Ravanger/canvas-glow/(commit log)

2026-10-09 docs: diode identification, torch-test result, cert workaround
2026-10-09 docs: make the fuse optional rather than unneeded
2026-10-09 docs(guide): add solderless breadboard bench steps
2026-10-09 docs(guide): fix debug example, FAULT causes and base resistor floor
2026-10-09 docs: add breadboard and final wiring drawings
2026-10-09 docs(breadboard): allow a plain LED as the bench load
2026-10-09 fix(firmware): correct base current estimate in comment
2026-10-11 feat: drop hover sensor and mode switch, knob-only dimming
    The capacitive hover sensor was unreliable on the bench. The light is now
    a plain dimmable halo: the knob always sets brightness, the bottom of the
    turn is off. Also removes the mode switch and the night auto-off timer.
    One 5 V 2 A adapter still powers both the ESP32 and the strip.
2026-10-11 feat: replace ESP32 with discrete transistor PWM dimmer
    Two-transistor astable (2N3904) timed by the B500K pot sets duty;
    2N7000 + BC327 buffer drives the four BC337 strip channels. Firmware,
    platformio.ini and the PlatformIO extension recommendation removed.
    Guides, README and drawings rewritten for the discrete circuit.
2026-10-15 feat: 2N3904 buffer instead of 2N7000, Rb 100k
    - Q3 is a 2N3904 driven from Q2 C through 47k
    - Rb 100k: max duty ~83%, total ~1.65 A at full
    - Step 1 test LED on 470 ohm so Q3 saturates
    - Replug test and latch-up troubleshooting row
2026-10-15 docs: breadboard test uses an LED only, no COB strip
2026-10-21 feat: IC version of the dimmer (NE555), alongside the discrete version
    Adds a second dimmer built around an NE555 instead of the
    two-transistor oscillator, with the same four BC337 output
    channels, same strip, same power. The discrete version is
    untouched; the README now presents both.
    - docs/GUIDE-IC.md: full IC build guide
    - docs/BREADBOARD-IC.md: bench test, no soldering
    - docs/img/wiring-ic.svg, docs/img/breadboard-ic.svg: IC drawings
2026-10-21 fix: correct 555 frequency for diode drops, note BC337 maker ratings
    The 1.1 kHz figure was the ideal no-diode-drop number. With the
    1N4148 drops at the microamp timing currents, the period stretches
    to ~1.1 ms (~0.9 kHz); the duty is barely affected because charge
    and discharge stretch together. Same correction to the timing-cap
    range (1 nF ~2 kHz, 4.7 nF ~400 Hz) and both SVG subtitles.
    Also: BC337 is 800 mA onsemi but 500 mA DC (1 A peak) Philips/NXP.
    Either is fine here (long sides peak 0.54 A, average 0.45 A at the
    83% cap) — noted so an NXP datasheet does not cause confusion.
    Small clarifications: pin-3 check reads DC (~2.7 V at full, peak
    ~3.3 V); breadboard step-2 LED current is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
2026-10-21 fix: 555 PWM topology (wiper to pin 7, 10k pull-up)
    The first version tied pot end 1 to +5V, which put a divider on the discharge path and killed oscillation for most of the knob travel (output stuck low below ~80%). The standard diode-steered form has the wiper on pin 7, a 10k pull-up, and the pot ends on D1 and (via 100k) D2, so neither path has a divider. Duty is now ~3.5-83%, and the bottom of the turn is a faint glow, not off.
    Also: 10-47uF at pins 8/1 for rail stability, ULN2803/2003 ruled out in the transistor table, A500K section dropped (B500K on hand), RESET-switch option for a true off, base-resistor fallback recheck.
2026-10-21 fix: IC drawing and doc issues from review
    - Wiper wire rerouted to y=328 so it clears the pin-5 cap plates
    (was running through them, looked like a short); pin-7 node
    moved to x=415 so the vertical clears the 6 THR / 7 DISCH labels
    - Pot end labels A/B moved above the pot ends (A was invisible
    inside the D1 triangle, B sat on the end-B wire)
    - 10-47 uF drawn as a polarized cap (curved negative plate, +
    mark on the positive lead) and + lead noted in the parts row
    and breadboard table
    - Guide changelog language removed (unmerged PR, nobody built
    the old version); breadboard symptom row now reads as plain
    miswiring
    - Pot ends defined: A = counter-clockwise, B = clockwise, so
    cl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
2026-10-21 fix: IC drawing nits from second review round
    - Breadboard 10-47 uF ground wire jogs left at y=200 and runs
    down at x=215, clear of the pin 1/2/4 stubs it used to cross
    - Electrolytic leads start at the curved plate apex (no 3 px
    gap): 10-47 uF in both SVGs, bulk cap in both SVGs
    - Wiring decoupling 100 nF label moved to y=208, clear of the
    ground symbol it nearly touched
    - Guide 'Works backwards' row shortened to 'swap the two end
    legs' to match the other wordings
2026-10-21 fix: IC drawing label collisions, caps to 16 V
    - Left pin labels moved inside the chip body in both SVGs:
    this clears the RESET, pin-2 and jog verticals that struck
    through 1 GND, 2 TRIG, 3 OUT and 4 RESET (including the
    jog vertical added last round)
    - Wiring: 4 POWER CHANNELS header moved above the first
    100 ohm label; bulk cap labels shifted left, clear of the
    red RESET wire
    - Wiring: pin-5 100 nF label moved up, clear of 5 CTRL
    - Breadboard: bulk label moved above the rail, decoupling
    100 nF moved clear of the cap wires, subtitle lines end
    left of the jack ground wire, pin 3 note moved right of
    the 2.2 nF ground wire
    - Electrolytics bumped to >= 16 V rating (was 10 V): ch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
2026-10-21 fix: IC drawing label collisions, round 5
    - NE555 title moved high in the chip body, clear of 3 OUT
    (y=340 would have landed on 4 RESET, so it went up
    instead)
    - Pin-5 cap plates shifted right to clear 5 CTRL, its 100 nF
    label now sits between the pin-6 and wiper wires
    - Breadboard pin-3 note moved right of the pin-5 ground
    wire and below the dashed box
    - Breadboard decoupling 100 nF moved to the left side of
    its cap, clear of the RESET wire
2026-10-21 fix: IC drawing detached label and pin-5 cap details
    - Breadboard decoupling label shortened to 100n and tucked
    in the gap beside its cap (was detached beside the jack)
    - Pin-5 100 nF label moved below the stub in both drawings
    (was sitting between wires where it could read as labelling
    the wiper wire)
    - Pin-5 ground wire now starts at the second plate's lower
    tip instead of overlapping the plate
2026-10-23 Add SPICE verification sims for guide circuits
    Netlists + models + helpers used to verify the numeric claims in
    docs/GUIDE.md and docs/GUIDE-IC.md (discrete astable and NE555 PWM):
    steady-state frequency, duty cycle, rail levels, and total current at
    three knob positions. README covers running ngspice without root,
    gotchas learned, and the results tables cited in the findings report.
2026-10-23 F1: discrete top duty is ~86%, not 83/81%
    Ideal 0.693RC formula gives 82.7%; both sims measure 85.4-85.9%.
    The gap: Vbe/Vce thresholds lengthen Q2's off-time, and Q3's 47k
    caps Q2C's swing at ~4.25 V, shortening Q1's on-time. §2 power
    framing corrected to the sim-measured totals (1.52-1.57 A, i.e.
    ~1.65 A or under — the old figure was conservative).
2026-10-23 F2: IC minimum duty is 1.6-2%, not 3.5%
    Arithmetic error: the line's own formula gives 10k/610k = 1.64%;
    sims measure 1.57-2.0%. Fixed in all copies: GUIDE-IC §3, §4, §8
    (bottom check 0.1 V -> 0.06 V; the 2.7 V top check is unchanged —
    datasheet-typical pin-3 high under load) and §9, plus the
    BREADBOARD-IC Step 2 pass line (N3).
2026-10-23 F3: make the discrete §9 rail check readable with a DC meter
    The specified tool reads the average (~4.0 V at full), not the
    scope peak (4.86-4.93 V in sims). '4.6 V or more' was unreachable;
    now states both readings.
2026-10-23 F4: add the second 10 kΩ needed by the RESET switch mod
    The §9 'real off switch' row replaces the pin 4 -> +5V tie with a
    10 kΩ pull-up, but the parts table listed only one 10 kΩ (pin 7).
2026-10-23 F5: qualify the breadboard LED current by color
    (5-1.9)/220 ≈ 14 mA for red; (5-3.2)/220 ≈ 8 mA for white/blue —
    now matches the IC breadboard doc's wording.
2026-10-23 F6: widen the discrete bottom check band to ~0-0.1 V
    A build showing the documented faint glow reads ~0.074 V DC on the
    drive rail (sim), which failed the old 0-0.05 V pass band; both
    documented outcomes (stall at 0 V, faint glow) now pass.
2026-10-23 T1: state per-version PWM frequency in the versions table
    Discrete ~1 kHz, IC ~0.9 kHz (sims: 893-907 Hz own / ~980 Hz
    external for the IC; the intro's '~1 kHz' stays as a round figure).
2026-10-23 F7: align electrolytic ratings to >=16 V
    The IC guide already specifies >=16 V on the same 5 V supply;
    both are safe, now one value across both guides.
2026-10-23 N6: reword the diode-drop sentence in §4
    'the duty barely moves' could be misread as the duty being constant
    across the knob (it runs 1.6-83%); it means the diode drops barely
    change the duty versus the ideal calculation.
2026-10-23 N1: add the breadboard-test parts to both parts tables
    The breadboard docs have no parts list of their own, and the LED
    current-limit resistors (470/220 Ω discrete, 220 Ω IC) plus the test
    LED appeared in neither guide's table — a builder following the
    table alone could not run the bench tests.
2026-10-23 N2: add the BC337 maker note to the discrete guide
    Mirrors the IC guide's note, with the discrete averages: ~0.46 A at
    the 86% cap (0.54 x 0.86) — under NXP's 500 mA DC but with less
    margin than the IC version's 0.45 A.
2026-10-23 N5: specify a slow-blow (T) fuse, not a fast one
    The 470-1000 uF bulk caps draw inrush on plug-in; a fast fuse risks
    nuisance-tripping where a slow-blow (or the PTC, listed first)
    tolerates it.
2026-10-23 Fix F1 mechanism wording: Q1's off-time, not on-time
    Q1 on-time IS Q2 off-time (both are the drive-high phase), so the
    old sentence claimed that phase both lengthens and shortens. The
    capped Q2C swing (~4.25 V) makes the coupling step onto Q1B smaller,
    so Q1's base recovers faster — that shortens Q1's OFF-time, the
    drive-low phase (sim: post-step -3.53 V, recovery factor 0.685 vs
    ideal 0.693).
2026-10-23 Fix 555a.lib header: VOH is pessimistic, not optimistic
    Measured sag is ~2.6 V no-load / ~1.8 V under full load vs 3.3-3.5 V
    on real parts — below reality, so pessimistic. The old 'no beta
    roll-off' justification was also wrong; the README attributes the
    sag to latch-node loading under the follower's base drive.
2026-10-23 List the bulk cap in both breadboard Step 1 tables
    Both drawings show the 470-1000 uF power-entry cap at the jack, but
    neither Step 1 wire table listed it. Electrically optional at bench
    currents (the 100 uF / 10-47 uF already decouple), but the table must
    match the drawing.
2026-10-23 Fix the sanity.cir row: measured ~255 Hz, band re-derived from tolerances
    The old row said '262.5 Hz / 3.92 ms period' — not reciprocals (262.5
    Hz = 3.81 ms; 3.92 ms = 255 Hz), and 262.5 sat just above the row's own
    expected band. Fresh run: periods 3.919-3.921 ms -> ~255 Hz, in-band.
    The band is re-derived analytically (a single log run gives a point, not
    a band): ideal 1.44/((RA+2RB)C) = 261.8 Hz; worst-case low with R +1%,
    C +5% = 246.9 Hz -> ~247-262 Hz, matching the original derivation
    within rounding.
2026-10-23 State that the discrete version has no off switch
    The Configuration list mentions the IC version's optional latching
    off switch but says nothing for the discrete version. One line
    completes it: unplug the adapter to switch off.
2026-10-23 Add a power-budget rounding note to both guides' section 2
    The tables round the exact figures (0.544 A long sides, 0.384 A
    short sides, 1.856 A total at 1.6 A per metre) to 0.54 / 0.38 /
    1.86 A. One note line after each table states the exact values;
    no table or paragraph number changed.
2026-10-23 Add a never-lights power check to both breadboard Step 1 Pass paragraphs
    A fully dark LED is a power problem (adapter polarity, 5 V rail
    actually ~5 V), distinct from the existing 'dark for most of the
    travel' miswire sentence. One sentence appended to each doc's
    Step 1 Pass paragraph.
2026-10-23 Fix the invalid section 8 DC checks on PWM-switched nodes
    The 'Transistor drop' (under 0.4 V good, over 0.6 V -> lower that
    base resistor) and 'Strip voltage' (4.5 V or more) rows judged
    PWM-switched nodes with a DC multimeter, which reads the
    duty-dependent average, not the on-state value. At full knob a
    healthy circuit averages ~0.8 V (discrete) / ~1.0 V (IC) across the
    BC337 and ~4.2 V / ~4.0 V across the strip, so it failed both
    checks; the Vce check passed only for a stuck-on fault. Reaching
    under 0.4 V needs over ~95% duty and 4.5 V over ~93%, beyond the
    knob caps (86% / 81-83%). Fresh runs of the committed sims
    (disc_endB.cir, ic_pwm_endB.cir) confirm: on-state collector
    plateau 0.08-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
2026-10-23 Warn against CMOS 555 substitutes in the IC guide
    The parts table specifies an NE555 but nothing warned against a
    CMOS substitute. The four base resistors (100/150 ohm from ~3.3 V
    pin 3 to ~0.7 V base) demand ~87 mA on-state, while the TLC555
    sources only ~10 mA typical (TI datasheet; absolute max 15 mA).
    One note after the parts table: use a bipolar NE555, and do not
    substitute without revalidating output drive.
2026-10-23 Label theory vs simulation figures in both power budgets
2026-10-23 State the one-channel pin-3 figure as higher than 2.7 V, not a measurement
2026-10-23 Tell builders to use their strip's pitch and rated power, with the current formula
2026-10-23 Say the 36 x 25.8 cm opening is the tested painting's; measure your own
2026-10-23 Label the fuse current as hold/rating and warn about stuck-full-on
2026-10-23 Fix BC337 maker-check wording: onsemi's 800 mA is a continuous rating, not a peak rating
2026-10-23 Harmonize the pin-3 load figure to ~87 mA in the 555 notes
2026-10-23 Resolve §2 conflict with main: keep strip-assumptions paragraph and labelled power budget
2026-10-24 GUIDE §4: call the end-B duty simulated, not measured
    The end-B figure came from simulation, not bench measurement. Quotes the 78–86% band across the sim runs in sim/README.md.
    Numbers: 78–86% is the band quoted in sim/README.md (line 121).
2026-10-24 GUIDE-IC §2: give the simulated total as a share of the adapter
    The 83% figure was the theoretical share; the simulated total is 1.52–1.57 A, which is the share shown here. Same wording as GUIDE.md §2.
    Numbers: 1.52/2 = 76%, 1.57/2 = 78.5%, quoted as 76–78%; the old 83% was the theory figure and is removed from this sentence.
2026-10-24 Power entry: PTC hold current derates when warm
    The old sentence said the PTC would not trip at full-on current, which does not hold inside a closed frame. Hold current is rated at room temperature, so the sentence now says to prefer 2.5 A and check the derating curve at in-frame temperature.
    Numbers: the new 2.5 A is a rating recommendation, not a computed value. The 2 A count rises by one from the new sentence. Full-on figure 1.86 A + ~0.1 A = ~1.96 A is unchanged from the existing §2 arithmetic.
2026-10-24 Checks: realistic BC337 saturation plateau
    Real BC337 parts often saturate above the sim figure of ~0.1 V, so the pass band is widened to a few tenths of a volt rather than tied to the datasheet number.
2026-10-24 GUIDE-IC: pin 3 pass values allow a datasheet-minimum 555
    The pin 3 pass values assumed a 3.3 V typical high level. A chip at the datasheet minimum sits lower, so the duty and troubleshooting checks now name that minimum and its reading.
    Numbers: NE555 VOH min 2.75 V at IOH = 100 mA, VCC = 5 V (TI datasheet). 0.82 × 2.75 V = 2.26 V, shown as ~2.3 V DC on a weak chip; 2.75 V peak at the minimum.
2026-10-24 GUIDE-IC §8: measure pin 8 with the current meter out
    A meter left in series with the supply drops voltage at full load and would read low at pin 8. The current meter must be out of the circuit for the VCC check.
2026-10-24 GUIDE: BC337 in the oscillator is marginal on VEBO
    The oscillator's BC337 substitute sees a reverse base swing close to its emitter-base breakdown rating. The substitution notes now say so, instead of listing it as equivalent.
    Numbers: BC337 VEBO = 5 V (datasheet). Reverse base swing −4.17 V, from the diag_discrete_q2c sim (sim/README.md: step onto q1b −4.17 V), quoted as ~4.2 V.
2026-10-24 GUIDE §5: diode test for the PNP BC327
    The diode-test lead swap for the PNP was missing; a reader using the NPN pattern on a BC327 would get the wrong base.
2026-10-24 Circuit: identify the pot legs
    End A and end B were defined by rotation only, with no way to tell the legs apart on the part. Adds the usual leg order seen from the front.
2026-10-24 Power entry: local decoupling returns, wire not tracks
    The decoupling capacitors need their own return to the star point, and the +5 V and GND feeds carry up to about 2 A, which perfboard tracks cannot.
    Numbers: no new figures. The added tokens restate existing component values (100 µF + 100 nF in GUIDE; 100 nF + 10–47 µF in GUIDE-IC) and the ~2 A feed current from §2 (1.86 A + ~0.1 A).
2026-10-24 Parts: jack rating, low-ESR bulk cap, timing cap type, IC extras
    Parts table gaps: the jack needs a rating that covers the fault current, the bulk cap should be low-ESR, the timing capacitor's dielectric matters for stability, and the IC build can use a socket and a real off switch.
    Numbers: 3 A = jack rating above the ~1.96 A full-on fault current (1.86 A + ~0.1 A base drive, §2).
2026-10-24 Power budget: duty figures are nominal
    The duty percentages are nominal. Pot tolerance and part spread shift the top of the knob, so the note points readers at the total current check in section 8.
2026-10-24 Drawings: move labels off wires
    Three labels sat on wires or rails: 'step 1 only' crossed the LED wire, the +5 V and GND rails ran under their labels, and the pin 3 caption ran into the wire at x=640. Only text positions and the rail end x changed; no values or connections.
2026-10-24 Drawings: clear the two moved labels
    breadboard.svg: 'step 1 only' overlapped the 1k label and the dashed
    box edge; centred in the box above it.
    breadboard-ic.svg: the pin 3 label crossed the CTRL-cap ground wire at
    x=480; start it at x=490, clear of the step-1 wire at x=640.
2026-10-24 check.py: summary also counts problems, not just check lines
    A check line that FAILs can carry WARN problems too; the old summary
    showed 0 WARN in that case.
2026-10-24 Drawings: draw the ground symbol in the wiring legends instead of the U+23DA glyph
    Many fonts lack U+23DA; the legend now reuses the existing #gnd symbol.
2026-10-24 Drawings: move the C2 and RC1 labels off their symbols in wiring.svg
2026-10-24 Parts: carry the 2.5 A PTC preference from section 4 into the parts table
    No new figure: the 2.5 A preference is copied from section 4's fuse note,
    so a builder shopping from the table alone does not buy a 2 A PTC.
2026-10-24 Parts: name example low-ESR series for the bulk capacitor
2026-10-24 sim: recheck supply current and discrete start-up with vendor models
    recheck.py runs ngspice and time-averages the adapter current from wrdata
    output. vendor.lib holds Philips 2N3904 / BC327-25 / BC337-25 / BC337-16
    models from the KiCad SPICE library. Results and limits are in sim/README.md;
    the older strip-plus-base figures are marked superseded.
2026-10-24 Power budget: re-simulated top-of-knob current, both guides
    sim/recheck.py with vendor BJT models, adapter current time-averaged:
    - discrete, 85.5 % duty: 1.588 A at 5.00 V (1.588/2 = 79 %), 1.669 A at
    5.25 V. BC337 Vce(on) 0.236 V -> strip at 4.764 V,
    1.856 x 4.764/5 = 1.77 A on, x 0.855 = 1.51 A; 1.588 - 1.51 = 0.08 A
    base drive + oscillator.
    - IC, 81-83 % duty: 1.445-1.481 A at 5.00 V (72-74 %), 1.518-1.555 A at
    5.25 V. Vce(on) 0.232 V -> 4.77 V, 1.77 A on.
    Replaces 1.52-1.57 A, ~4.85 V and ~1.80 A, which came from generic models
    with no collector resistance (sim/README.md, Recheck section).
2026-10-24 Checks: strip on-voltage from the re-simulated saturation drop
    sim/recheck.py: BC337 Vce(on) 0.23-0.25 V at 0.38-0.54 A in every case,
    so the switched strip sees ~4.75 V, not ~4.9 V. Datasheet bound: onsemi
    BC337 VCE(sat) max 0.7 V at IC = 500 mA, IB = 50 mA.
2026-10-24 Checks: drive-rail DC level at full from the re-simulation
    sim/recheck.py, discrete at the top of the knob from 5.00 V: rail 4.93 V
    when on, 4.22 V time-averaged (0.855 x 4.93 = 4.22). The old 4.0 V
    matches only a 4.75 V supply (sim: 4.01 V).
2026-10-24 Troubleshooting: what the start-up simulation shows
    sim/recheck.py startup/knob: supply ramps of 10 us, 1 ms, 10 ms, 100 ms
    and 1 s all start the oscillator at mid and top (~1.1 kHz). At the bottom
    stop Q1 and Q2 both stay on (strip off); after a 100 ms power-up there, a
    1 s turn toward mid starts oscillation ~10 % into the turn.
2026-10-24 GUIDE §8: take the current meter out for the drive-rail reading
    A 10 A meter shunt in series drops ~0.1 V at 1.6 A and lowers the
    ~4.2 V full-knob reading; matches the note on GUIDE-IC §8's VCC row.
2026-10-24 Add CC0 1.0 license
    Maintainer asked for the most permissive license; CC0 is a public-domain
    dedication covering docs, drawings and scripts alike. LICENSE text from
    GitHub's licenses API (cc0-1.0). sim/vendor.lib is copied from the GPL-3.0
    KiCad-Spice-Library, so it is excluded and marked as GPL-3.0.
2026-10-24 CI gate: diff the PR merge commit against its first parent
    The PR checkout is the merge of the PR into the current main, so HEAD^1
    is that main and the diff holds only the PR's own changes. A stale
    base.sha could count changes that landed on main as the PR's.
2026-10-24 IC supply current: count the base drive pin 3 sources
    recheck.py's ideal PWM source took its current from ground, so i(Vs)
    missed the ~70 mA of BC337 base drive. Fdrv now mirrors it from vcc.
    Re-run (python sim/recheck.py current):
    5.00 V: 1.507 A at 81 %, 1.544 A at 83 % (was 1.445 / 1.481)
    5.25 V: 1.585 / 1.624 A (was 1.518 / 1.555)
    Check: 0.81 x 1.767 A + 4 mA + 0.81 x 87 mA = 1.505 A.
    1.50/2 = 75 %, 1.54/2 = 77 %. Still under the 1.65 A budget.
    Discrete figures unchanged (its drive stage was already on the supply).
2026-10-24 Guides: replace stale BC337 drop and drive-rail figures
    Scope check (both guides, section 8) said ~0.1 V in sims: that came from
    the superseded generic models. The vendor-model recheck measures
    0.23-0.25 V (sim/README.md), datasheet max 0.7 V at 500 mA.
    Drive rail: the recheck measures 4.93 V when on, and section 8/9 already
    say ~4.9 V; GUIDE section 4/5, GUIDE-IC section 12 and both discrete
    drawings said 4.8 V. Base resistors unaffected:
    (4.93 - ~0.9 V) / 180 = 22 mA, forced beta ~25 at 0.544 A.
2026-10-24 Fuse note: top of the knob is ~1.6 A, 1.96 A is only the stuck-on fault
    The paragraph said "Full on draws about 1.96 A", which reads as the
    top of the knob. Section 2: discrete 1.59 A, IC 1.50-1.54 A at 5.00 V;
    1.856 A + ~0.1 A base drive only at 100 % duty (lost wiper, section 9).
    Added that a PTC trips at about twice its hold current.
2026-10-24 Build order: power up with no strips, then wire them one at a time
    Step 4 went straight from the perfboard to mounting, with no rail or
    polarity check and nothing on how the strip connects. New steps: first
    power-up without strips (rail +5 V, drive rail or pin 3 follows the
    knob, same readings as the section 8 Duty check), strip wiring (+ to
    the rail, - to its own BC337 collector), mount, checks. Tools line adds
    strippers, cutters, mounting tape and the 10 A meter jack. No figures
    changed; the snapshot diff is only new counts of existing values.
2026-10-24 Breadboard pages: polarity check, split rails, orientation, IC step 2
    - Measure the rails (+5 V, not -5 V) before fitting the electrolytics.
    - Warn that long breadboards split their power rails.
    - Diode band, electrolytic stripe, LED leg and pot leg order on the
    page itself; 555 straddles the centre channel; drawings are
    connection diagrams. The discrete drawings place the pot ends as
    wired, not in leg order; say to wire by the A/B labels.
    - IC step 2: remove the step-1 220 ohm too, or it stays on pin 3.
    - Discrete step 2: expected drive-rail DC, same as GUIDE section 8
    (0-0.1 V bottom, 0.855 x 4.93 V = 4.2 V top).
    - White/blue LED at 220 ohm: (5 - 3.0..3.2 V - ~0.05 V) / 220 = 8-9 m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
2026-10-24 Troubleshooting: no light, adapter trips, hot parts, bad cap, dim segment
    Rows for faults the tables did not cover: nothing lights (measure the
    rail: 0 V, -5 V or +5 V each point somewhere), adapter or polyfuse
    cuts out, a transistor/resistor/555 runs hot, an electrolytic is hot or
    bulging, one segment much dimmer. No figures changed; the snapshot
    diff is only the values these rows name.
2026-10-24 Clarity: name the pot sides, explain the discharge path, 2N2222A pins
    GUIDE-IC said "upper/lower pot half", which a pot does not have; it is
    now the end-A side (charge, via D1) and end-B side (discharge, via D2
    and the 100k), matching the netlist. "Keeps the discharge path clean"
    now says why. Both guides: the metal-can 2N2222A pinout differs from
    the plastic P2N2222A.
2026-10-24 README: status, which version, skill, safety, terms
    - Says plainly that nothing is bench-tested yet; "tested configuration"
    becomes "the configuration the guides are worked out for".
    - "Which version?" replaces the Getting started list, which repeated
    the Documentation list.
    - Hardware line names the discrete and IC parts; skill line; safety
    notes (polarity, feed current, 1 cm clearance, heat check, stuck-on
    fault); a short glossary for PWM/duty, saturated, VEBO/hFE, low-ESR,
    PTC, star point.
    - 1 kHz vs 0.9 kHz stated once. Figures are the guides' own: ~1.5 A
    feed (sections 2), ~2 % IC minimum duty (GUIDE-IC section 3).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
2026-10-24 Round two figures the review caught
    GUIDE-IC 5.25 V range: sims give 1.585-1.625 A, so 1.59-1.63 A.
    README feed current: discrete top of knob is 1.59 A, so "up to about
    1.6 A" rather than the IC's 1.5 A.
2026-10-24 Breadboard step 2: also remove the step-1 470 Ω
    Matches BREADBOARD-IC step 2. No value changes; the snapshot diff is the
    470 Ω count going from 1 to 2.
2026-10-24 Docs: split dense paragraphs into steps and bullets
    Power budget, How it works, the fuse note, the oscillator timing note
    and the BC337 maker check become short bullets; breadboard Pass
    paragraphs become Pass / If not lists; README gets a six-step
    How to follow a build. Wording only: no number changed
    (tools/check.py numbers PASS, snapshot untouched).
2026-10-24 Docs: add part photos from Wikimedia Commons with credits
    Eleven freely licensed photos (CC BY, CC BY-SA, public domain),
    resized Commons renditions stored in docs/img/photos/, no hotlinks.
    Parts galleries in both guides' section 1, the TO-92 face by the
    pin-order notes, the NE555 by its pinout, a canvas back in section 6
    (identical in both guides), a breadboard in both breadboard Setups.
    Each photo is credited where it appears and in README > Image
    credits; README > License notes the photos keep their own licences.
    No number changed (tools/check.py numbers PASS).
